dancesWithMachines/dryer_cntrl/(commit log)

2025-07-05 Add status param support
    This commit adds "status" param support. It ditches the current behavior,
    that when time is set, the device already starts working. Instead, the
    temperature and time can be now set independently and dailing them in is
    postponed untill status start is set. The status stop can be used to
    stop the device. If the device is running allready then changes to time
    and teperature are done live.
2025-07-05 Fix and unify messages
    Add missing new lines, dots or spaces. Unify the messages so they are
    the same format.
    [dryer_cntrl.ino]
2025-07-05 Add timer support
    Use rp2040 hardware timer to estimate time left. This enables
    "get time" command.
2025-07-05 Add help content
    Changes:
    * move printHelp() to dedicated file,
    * add base manual.
2025-07-05 Clean up the code
    Clean up the code:
    * Add function descriptions.
    * Move some of the functions so they're logically grouped.
    * Fix some of function arguments names.
    [dryer_cntrl.ino]
2025-07-09 Add carriage return and local echo
    Add carriage return to prints so output parses correctly on all systems.
    Add local echo, for mor shell like expeirience.
    [HWTimer.h, dryer_cntrl.ino, help.cpp]
